snoeckmichiel-ctrl/Claude-questions/firmware/trekker_gps/config.h

// config.h - Pas hier alles aan voor jouw tractor. De rest hoef je niet te wijzigen.
#pragma once

// ---------------------------------------------------------------------------
// GPS-module (Quectel LC29H, bv. de Waveshare LC29H GPS/RTK HAT)
// ---------------------------------------------------------------------------
#define GNSS_RX_PIN      16       // ESP32 ontvangt hier: naar HAT-headerpin 10 (module TX)
#define GNSS_TX_PIN      17       // ESP32 zendt hier:    naar HAT-headerpin 8  (module RX)
#define GNSS_BAUD        115200   // fabrieksinstelling van de LC29H

// Bij het opstarten stuurt de ESP32 instellingen naar de module.
#define GNSS_SEND_CONFIG 1
// Tijd tussen metingen in ms. 200 = 5 Hz (minimum voor Amatron 3), 100 = 10 Hz.
// Let op: de LC29H(DA) doet RTK maar aan 1 Hz. Neem de (EA) voor RTK aan 10 Hz.
#define GNSS_FIX_INTERVAL_MS 200
// GSV (satellietlijst voor de tablet) één keer per zoveel metingen. 0 = uit.
#define GNSS_GSV_EVERY   5
// EGNOS (SBAS) aanzetten. Dan meldt de module DGPS-kwaliteit, en die heeft de
// Amatron 3 nodig om de bewerkte stroken groen te tonen in plaats van geel.
#define GNSS_ENABLE_SBAS 1

// ---------------------------------------------------------------------------
// Amatron 3 (RS232 via een MAX3232-module, NOOIT rechtstreeks aansluiten)
// ---------------------------------------------------------------------------
#define AMATRON_ENABLED  1
#define AMATRON_TX_PIN   26       // naar MAX3232 TXD/T1IN
#define AMATRON_RX_PIN   27       // van MAX3232 RXD/R1OUT (niet echt nodig)
#define AMATRON_BAUD     19200    // moet gelijk zijn aan de instelling in de Amatron
#define AMATRON_SEND_GGA 1
#define AMATRON_SEND_VTG 1
#define AMATRON_SEND_GSA 1
#define AMATRON_SEND_RMC 0
#define AMATRON_SEND_ZDA 0
#define AMATRON_TALKER_GP 1       // $GNGGA -> $GPGGA, voor oudere terminals
#define AMATRON_STRIP_GSA_SYSID 1 // NMEA 4.10-extra veld in GSA weglaten
#define AMATRON_RTK_AS_DGPS 1     // RTK-kwaliteit (4, 5) als DGPS (2) melden, zie handleiding

// ---------------------------------------------------------------------------
// Tablet
// ---------------------------------------------------------------------------
#define TABLET_USB_ENABLED 1
#define TABLET_USB_BAUD    115200 // zelfde waarde instellen in de tablet-app

// Klassieke Bluetooth voor andere apps zoals AgOpenGPS. Alleen op een gewone
// ESP32 (ESP32-WROOM-32 / DevKitC). Standaard uit om geheugen te sparen.
#define TABLET_BT_ENABLED  0
#define TABLET_BT_NAME     "Trekker-GPS"

// RTCM-correcties die de tablet terugstuurt (bv. AgIO NTRIP-client in
// AgOpenGPS) worden doorgegeven aan de GPS-module.
#define TABLET_FORWARD_RTCM 1

// ---------------------------------------------------------------------------
// Hotspot van de Android-tablet (aanbevolen)
// Het kastje verbindt met de hotspot van de tablet. De tablet houdt zo zijn
// mobiele internet voor Google Drive, en het kastje krijgt internet voor NTRIP.
// Vraagt de bibliotheken "ESPAsyncWebServer" en "AsyncTCP" van ESP32Async.
// ---------------------------------------------------------------------------
#define HOTSPOT_ENABLED    1
#define HOTSPOT_SSID       "Naam van de hotspot"   // zoals op de tablet ingesteld
#define HOTSPOT_PASSWORD   "wachtwoord"
// Android kiest bij elke start van de hotspot een ander adresbereik. Het kastje
// neemt daarin altijd het adres dat op .200 eindigt, zodat de app het vindt.
#define HOTSPOT_HOST_OCTET 200

// Adres van het kastje melden aan je Drive-koppeling (drive/Code.gs), zodat de
// app het kastje meteen vindt. Optioneel: leeg laten mag.
#define DRIVE_URL          ""   // web-app-URL, eindigt op /exec
#define DRIVE_KEY          ""   // dezelfde sleutel als in Code.gs

// ---------------------------------------------------------------------------
// Eigen wifinetwerk van het kastje, als reserve (http://192.168.4.1)
// Handig als de hotspot niet werkt. Zonder internet, dus zonder Drive.
// ---------------------------------------------------------------------------
#define BOX_AP_ENABLED     1
#define BOX_AP_SSID        "Trekker-GPS"
#define BOX_AP_PASSWORD    "trekker123"  // minstens 8 tekens, verander dit

// ---------------------------------------------------------------------------
// Bluetooth Low Energy, als alternatief voor de hotspot.
// ---------------------------------------------------------------------------
#define BLE_ENABLED        0
#define BLE_NAME           "Trekker-GPS"

// ---------------------------------------------------------------------------
// RTK-correcties via NTRIP. Gebruikt het internet van de tablet-hotspot.
// ---------------------------------------------------------------------------
#define NTRIP_ENABLED    0
#define NTRIP_HOST       "caster.centipede.fr"  // FLEPOS of een andere caster mag ook
#define NTRIP_PORT       2101
#define NTRIP_MOUNT      "MOUNTPOINT"           // dichtstbijzijnde basisstation
#define NTRIP_USER       "centipede"
#define NTRIP_PASSWORD   "centipede"
#define NTRIP_GGA_INTERVAL_MS 10000             // positie terugsturen (nodig voor VRS)

// ---------------------------------------------------------------------------
// Diversen
// ---------------------------------------------------------------------------
#define STATUS_LED_PIN   2        // ingebouwde led op de meeste DevKits
// 1 = statusregels beginnend met "#" op USB. Laat op 0 tijdens gebruik met de tablet.
#define DEBUG_OUTPUT     0
