snoeckmichiel-ctrl/Claude-questions/firmware/trekker_gps/web_app.h

// Automatisch gemaakt door tools/build_web.py. Niet met de hand aanpassen.
#pragma once
#include <Arduino.h>

static const size_t WEB_APP_GZ_LEN = 28584;
static const uint8_t WEB_APP_GZ[] PROGMEM = {
  0x1f, 0x8b, 0x08, 0x00, 0x00, 0x00, 0x00, 0x00, 0x02, 0xff, 0xcc, 0xbd, 0xe9, 0x96, 0xdb, 0x48, 0x92, 0x2e, 0xf8, 0x5f,
  0x4f, 0x01, 0x45, 0x76, 0x15, 0xc1, 0x14, 0x89, 0x20, 0x19, 0x8b, 0x62, 0x51, 0x84, 0x46, 0x5b, 0x4a, 0xaa, 0xd4, 0x76,
  0x15, 0x91, 0xca, 0xaa, 0x52, 0xaa, 0xf2, 0x80, 0x24, 0x48, 0x42, 0x01, 0x02, 0x4c, 0x00, 0x8c, 0x45, 0x2a, 0x9d, 0xd3,
  0xef, 0x70, 0xdf, 0x61, 0xce, 0xb9, 0x7f, 0xe7, 0xc7, 0xcc, 0xff, 0xdb, 0x6f, 0xd2, 0x4f, 0x32, 0xf6, 0x99, 0x2f, 0x70,
  0xc7, 0x42, 0x46, 0x48, 0xea, 0x5b, 0x9d, 0xdd, 0xa5, 0x20, 0x00, 0x5f, 0xcd, 0xcd, 0x6d, 0x73, 0x33, 0xf3, 0x7b, 0xb7,
  0xc7, 0xc9, 0x28, 0xbf, 0x5a, 0x04, 0xce, 0x2c, 0x9f, 0x47, 0xc7, 0xb7, 0xee, 0xe1, 0x8f, 0x13, 0xf9, 0xf1, 0xf4, 0x68,
  0x23, 0x8e, 0x36, 0xf0, 0x22, 0xf0, 0xc7, 0xf4, 0x67, 0x1e, 0xe4, 0xbe, 0x33, 0x9a, 0xf9, 0x69, 0x16, 0xe4, 0x47, 0x1b,
  0xcb, 0x7c, 0xd2, 0xdd, 0xdb, 0x50, 0xaf, 0x63, 0x7f, 0x1e, 0x1c, 0x6d, 0x9c, 0x87, 0xc1, 0xc5, 0x22, 0x49, 0xf3, 0x0d,
  0x67, 0x94, 0xc4, 0x79, 0x10, 0x53, 0xb1, 0x8b, 0x70, 0x9c, 0xcf, 0x8e, 0xc6, 0xc1, 0x79, 0x38, 0x0a, 0xba, 0xfc, 0xd0,
  0x71, 0xc2, 0x38, 0xcc, 0x43, 0x3f, 0xea, 0x66, 0x23, 0x3f, 0x0a, 0x8e, 0xfa, 0x1d, 0x67, 0xee, 0x5f, 0x86, 0xf3, 0xe5,
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
  0xec, 0x07, 0x3b, 0xbe, 0x8d, 0x7a, 0x5b, 0xa3, 0xe1, 0xd6, 0xae, 0x5f, 0x42, 0xbd, 0xde, 0x6e, 0x7f, 0xbb, 0x37, 0x54,
  0xd5, 0x2d, 0x14, 0xda, 0xd9, 0x21, 0xcc, 0xd8, 0x21, 0xf0, 0x6f, 0xf3, 0x12, 0x6c, 0x6d, 0xb7, 0x0f, 0xeb, 0x10, 0x68,
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
};
