snoeckmichiel-ctrl/Claude-questions/(commit log)

2026-10-16 Add tractor GPS firmware for tablet and Amatron 3
    ESP32 firmware that reads NMEA from a Quectel LC29H and splits it:
    all sentences go to a tablet over USB and Bluetooth, while the
    Amatron 3 gets GGA, VTG and one GSA per epoch over RS232 at 19200
    baud. RTCM corrections are passed from the tablet or an optional
    built-in NTRIP client to the receiver. Includes host-side tests for
    the NMEA filter and a Dutch build and wiring guide.
    Claude-Session: https://claude.ai/code/session_01VJrkKiqqCjMnoK9mwdrFFs
    [config.h, nmea.h, trekker_gps.ino]
2026-10-16 Add Trekker-GPS tablet app with ISOXML export
    A browser app served by the ESP32 over its own Wi-Fi access point.
    It shows the tractor on a field map, records field boundaries,
    draws worked strips at the working width and exports an ISOXML v3
    TASKDATA zip with the boundary and a time log of the track.
    - app/src: NMEA parser, local geometry, ISOXML and ZIP writers,
    demo tractor simulator and the UI
    - tools/build_web.py bundles the app into app/dist/index.html and
    a gzipped firmware header
    - firmware serves the app and streams NMEA over a WebSocket;
    Bluetooth now defaults to off to save memory
    - unit tests for the app modules and a Playwright test that drives
    the demo tractor through t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
2026-10-16 Redesign app for a clean, professional look
    - Calm layout: top bar with product name, field and GPS status,
    floating stats card, map controls and one action bar with a large
    start/stop work button
    - Welcome screen for choosing the GPS connection, styled dialogs for
    settings, export summary and confirmations instead of browser popups
    - Banner while recording a boundary, day/night/auto theme, larger
    tractor and implement drawing, phone layout
    - Product name, version, company and credits in one file (brand.js),
    shown under "Over" in the settings and written into the ISOXML
    - README: screenshots, rebranding and a checklist before selling
    - Browser test covers the new screens and saves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
    [web_app.h]
2026-10-16 Save every field on the tablet and in Google Drive
    - store.js keeps all fields in IndexedDB with autosave every 3 s;
    data from the first app version is migrated
    - Percelen list: new, open, export and delete fields, with a
    Drive status badge per field
    - sync.js uploads changed fields to the user's own Google Drive
    through an Apps Script web app (drive/Code.gs): ISOXML zip,
    full JSON backup and a Google Sheets overview; fields can be
    restored on another tablet
    - The app is now an installable PWA with offline cache, published
    to GitHub Pages by a workflow that runs the tests first
    - GPS over Bluetooth LE (Nordic UART service) so the tablet keeps
    its own internet; the ESP32 Wi-Fi a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
2026-10-16 Make the embedded app build identical on every machine
    The gzip header OS byte differs between Python versions, which made
    the CI freshness check fail. Pin it to "unknown".
    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
2026-10-16 Connect the GPS box through the Android tablet's hotspot
    The box now joins the tablet's hotspot, so the tablet keeps its
    mobile internet for Google Drive and the box gets internet for NTRIP.
    - Firmware: hotspot client with a fixed .200 address inside the
    hotspot's changing subnet, back to DHCP after a disconnect; NMEA
    stream as Server-Sent Events on /events and /api/info, with CORS
    for the online app; optional address report to the Drive script;
    own access point kept as fallback; BLE optional
    - App: "Hotspot" is the first choice; box.js finds the box via the
    manual address, the last known address, the address reported to
    Drive, then a scan of 192.168.x.200, and reconnects on its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
    [config.h, trekker_gps.ino, web_app.h]
2026-10-17 Match the Amatron 3 manual: DGPS quality, SBAS and menu paths
    From the Dutch AMATRON 3 manual (MG5560-NL-II, software 01.09.00):
    the terminal shows worked area green only for DGPS with HDOP up to 6,
    and its quality table has no RTK entry.
    - Firmware: enable SBAS (EGNOS) on the LC29H and report RTK fixed or
    float as DGPS to the Amatron (both configurable)
    - README: GPS port location, "GPS-driver" > "Overige" at 19200 baud,
    lightbar path, antenna geometry and the quality table
    - NMEA test for the quality mapping
    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
    [config.h, nmea.h, trekker_gps.ino]
